minhtenlado/ST25DV04KC-NFC-Energy-Harvesting/schematic.pdf

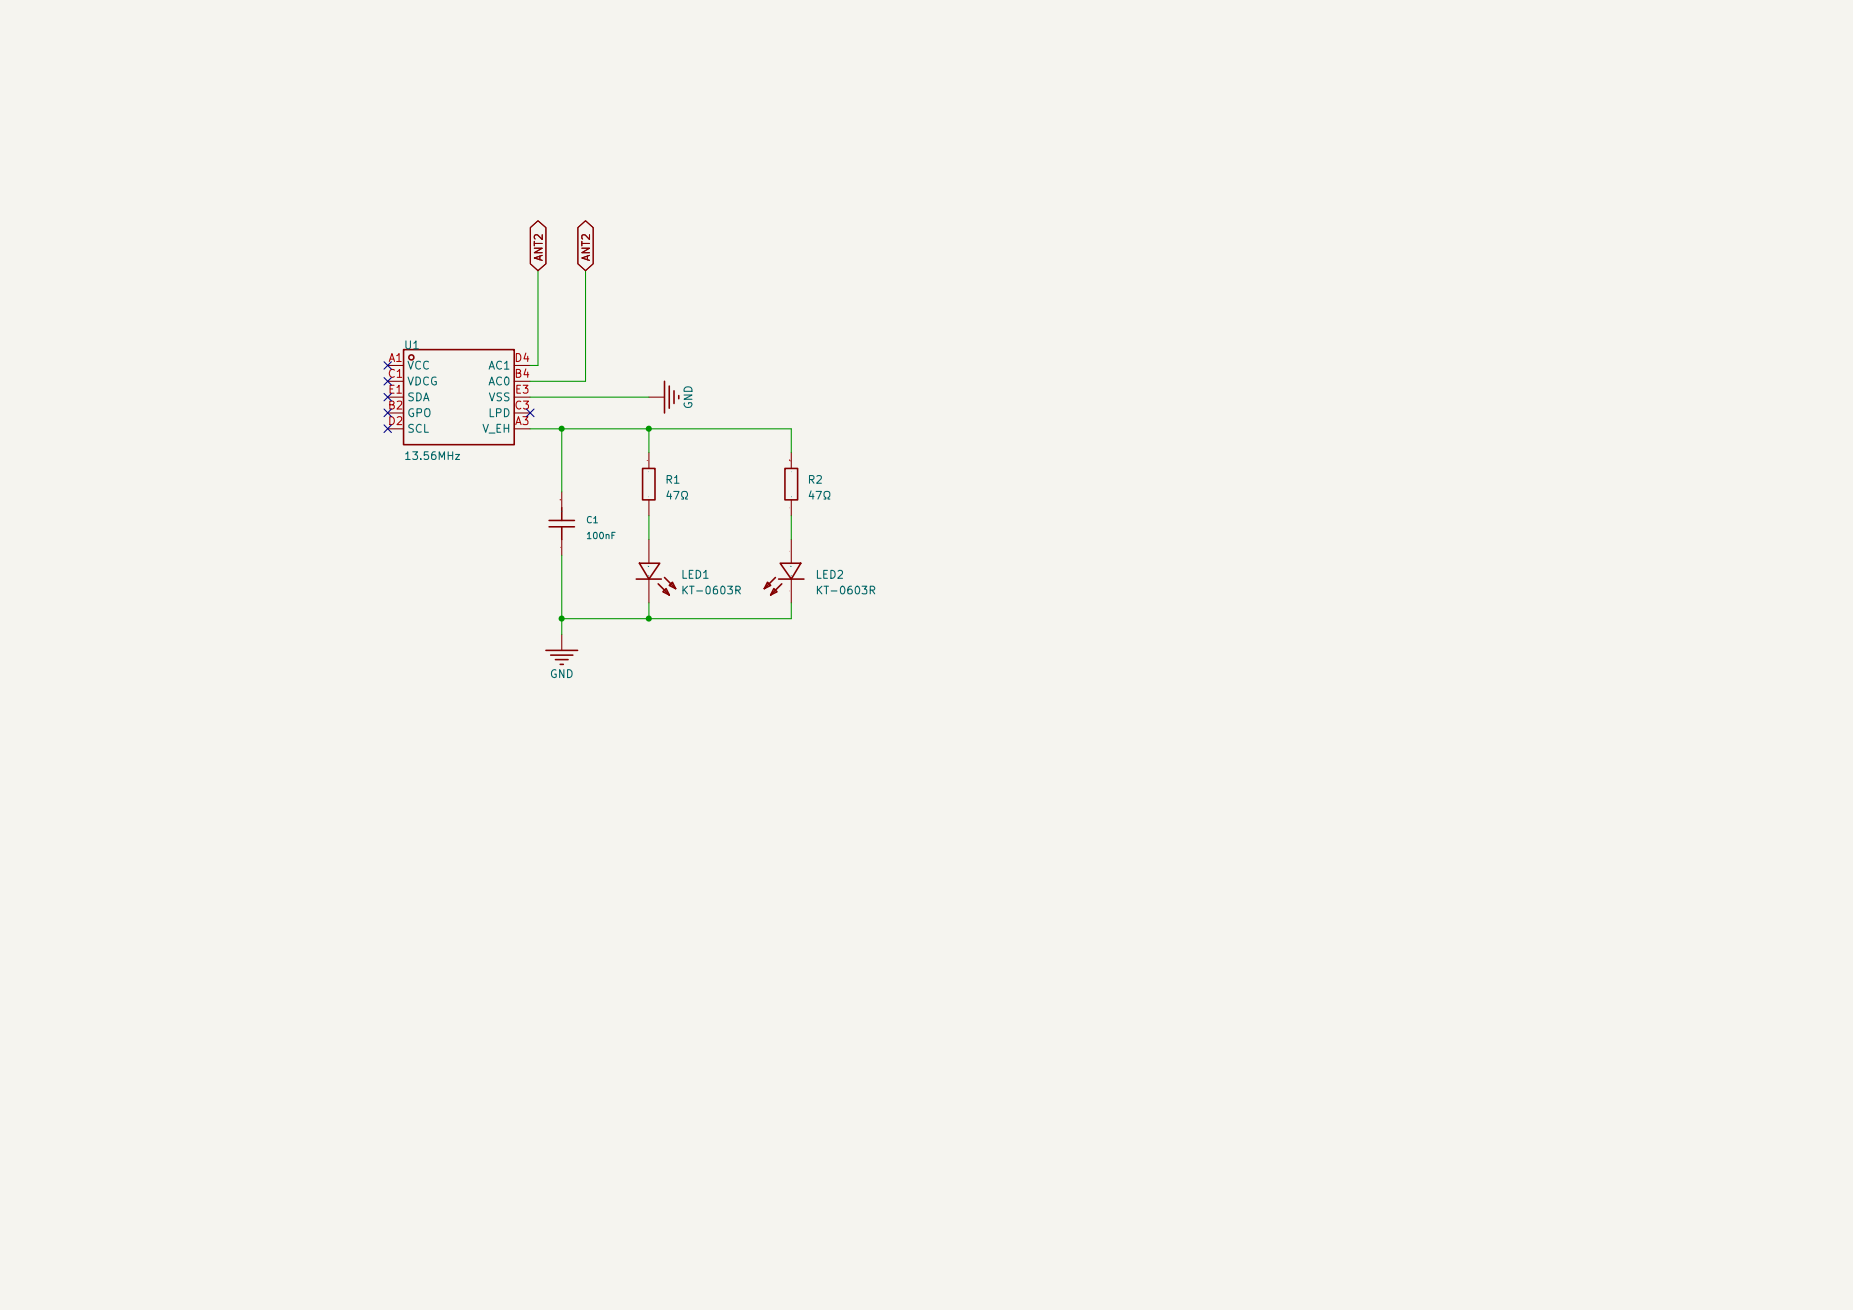
[picture p9: page 1]
