minhtenlado/ST25DV04KC-NFC-Energy-Harvesting/NFC_LED_ST25DV.kicad_pcb

## KiCad design NFC_LED_ST25DV.kicad_pcb (2026-11-03)

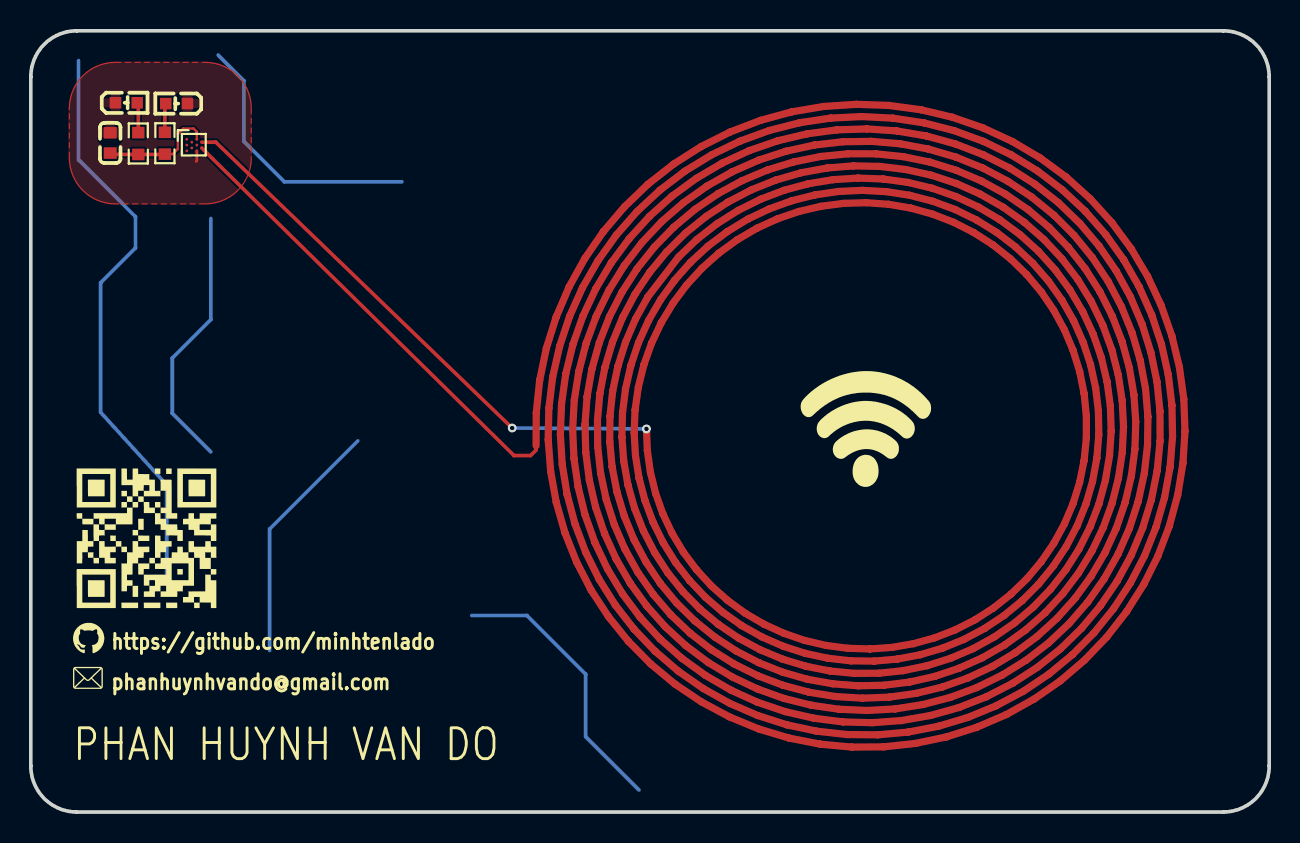
[picture p10: board NFC_LED_ST25DV.kicad_pcb from above]

Board: 2 copper layers, 85.6 x 54.0 mm, 6 parts (0 on the bottom side), 5 nets.

Parts:
C1: C0603
LED1, LED2: LED-SMD_L1.6-W0.8-R-RD
R1, R2: R0603
U1: WLCSP-10_L1.7-W1.5-P0.50_ST_ST25DVXX

Connections:
$1N9: C1.2, R1.2, R2.2, U1.A3
$1N10: LED2.1, R2.1
$1N11: LED1.1, R1.1
ANT2: U1.B4, U1.D4
GND: C1.1, LED1.2, LED2.2, U1.E3
