minhtenlado/ST25DV04KC-NFC-Energy-Harvesting/(commit log)

2026-11-03 Initial release - ST25DV04KC NFC Energy Harvesting PCB
    [NFC_LED_ST25DV.kicad_pcb, NFC_LED_ST25DV.kicad_sch, bom.csv, designators.csv, positions.csv]
2026-11-03 Remove KiCad history directory
2026-11-03 Simplify PCB Coil Creator settings description
    Removed redundant text about the circular spiral PCB coil generator.
